Gepetto/DieBieSlaveduino/photos/stlink.jpeg

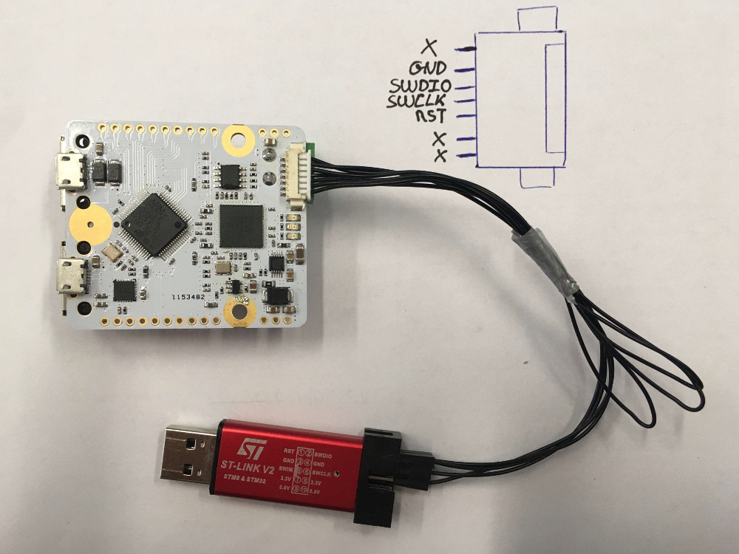
photos/stlink.jpeg
