Gepetto/DieBieSlaveduino/photos/twincat_opmode.png

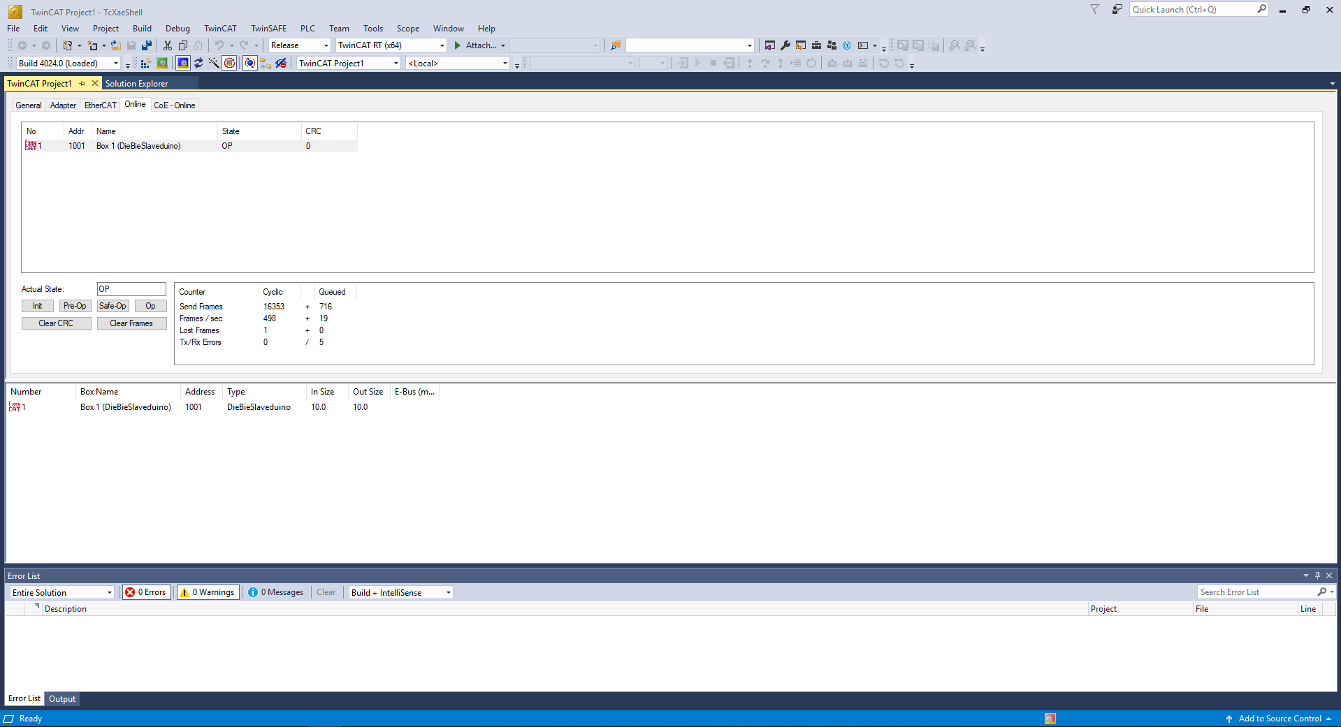
photos/twincat_opmode.png
