Gepetto/DieBieSlaveduino/hardware/BOM ethercat.ods

Sheet: ethercat
Designator | MPN origine | Quantity x1 | Quantity x5 | Quantity x4 | MPN remplacement farnell | ref Farnell | Référence Digi-Key | statut
C1, C4, C7, C8, C67, C71, C89 | C0805C104K5RACTU | 7 | 35 | 28 | C0805X104K5RACTU | 1414041 | x
C2, C3 | 12065D475KAT2A | 2 | 10 | 8 | C1206C475K5PACTU | 1572637 | x
C5, C6, C68, C69 | GRM21BR71C475KA73L | 4 | 20 | 16 | GCM21BR71C475KA73L | 2611880 | x
C12, C20, C25, C44, C46 | GRM155R71H223KA12D | 5 | 25 | 20 | GCM155R71H223KA55D | 2688473 | x
C13 | GRM155R60J225ME15D | 1 | 5 | 4 | GRM155R60J225ME15D | 2362088 | x
C14, C17, C19, C36, C40, C41 | GRM155R71E104KE14D | 6 | 30 | 24 | MC0402B104K250CT | 2320759 | x
C15, C16, C18, C72, C75 | GRM188R61C225KE15D | 5 | 25 | 20 | CC0603KRX5R7BB225 | 1458897 | x
C21, C22, C23, C24, C47, C48, C49, C50 | GRM1555C1H150JA01D | 8 | 40 | 32 | GRM0335C1H150JA01D | 2494203 | x
C26, C27, C31, C32, C33, C34, C35, C42, C43, C45, C51, C52, C53, C54, C56, C57, C58, C61, C62, C63, C64, C65, C66, C70 | GRM155R71C104KA88D | 24 | 120 | 96 | CC0402KRX7R7BB104 | 9402047 | x
C28 | 04026D105KAT2A | 1 | 5 | 4 | 04026D105KAT2A | 1327658 | x
C29 | GRM1555C1H221JA01D | 1 | 5 | 4 | CC0402JRNPO9BN221 | 3019240 | x
C37 | GRM155R71E153KA61D | 1 | 5 | 4 | x | x | 490-3251-1-ND
C38, C39, C59, C60 | GRM1555C1H180JA01D | 4 | 20 | 16 | x | x | 490-5858-1-ND
C73, C74 | GRM188R60J106ME47D | 2 | 10 | 8 | CC0603MRX5R5BB106 | 1458902 | x
C134, C143 | GRM21BR70J106KE76L | 2 | 10 | 8 | CGA4J1X7R0J106K125AC | 2210949 | x
D1, D2, D6, D9, D10, D11 | KP-2012SGC | 6 | 30 | 24 | KP-2012SGC | 1318243 | x
D3, D5 | STTH4R02U | 2 | 10 | 8 | STTH4R02U | 1295277 | x
D4, D7, D8 | PMEG3050EP | 3 | 15 | 12 | PMEG3050EP | 1829197 | x
IC | STM32F303RET6 | 1 | 5 | 4 | x | x | 497-15163-ND
IC1 | LAN9252/ML | 1 | 5 | 4 | LAN9252/ML | 2920821 | x
IC5 | CP2104-F03-GM | 1 | 5 | 4 | CP2104-F03-GM | 2930580 | x
IC8 | M24C16-WMN6P | 1 | 5 | 4 | x | x | 497-17785-1-ND
J1, J4 | 74980111211 | 2 | 10 | 8 | 74980111211 | 2407403 | x
J2 | 691313510002 | 1 | 5 | 4 | 691313510002 | 1641993 | x
J3 | 53261-0771 | 1 | 5 | 4 | 53261-0771 | 1125361 | x
J7, J8 | USB3075-30-A | 2 | 10 | 8 | USB3075-30-A | 2443115 | x
J11 | EVQPLMA15 | 1 | 5 | 4 | EVQPLMA15 | 2079484 | x
L1 | 744052100 | 1 | 5 | 4 | 744052100 | 1635854 | x
L2, L3, L4, L5, L6 | BLM18PG330SN1D | 5 | 25 | 20 | BLM18PG330SN1D | 1515742 | x
L8 | SRN2512-2R2M | 1 | 5 | 4 | SRN2512-2R2M | 2428203 | x
R1, R2, R3, R4, R13, R14, R15, R16 | CRCW040249R9FKED | 8 | 40 | 32 | MCMR04X49R9FTL | 2073090 | x
R5, R12, R24, R25, R26, R27, R28, R51, R63, R66 | CRCW04024K75FKED | 10 | 50 | 40 | CRCW04024K75FKED | 1469713 | x
R6, R7, R18, R30, R31, R32, R33, R64, R107, R108 | CRG0402F470R | 10 | 50 | 40 | CRG0402F470R | 2331533 | x
R8, R17 | MCHP03W8F100JT5E | 2 | 10 | 8 | MCWF06P10R0FTL | 2694037 | x
R9, R11 | CRCW0402240RFKED | 2 | 10 | 8 | CRCW0402240RFKED | 2140710 | x
R10 | CRG0402F12K | 1 | 5 | 4 | CRG0402F12K | 2331453 | x
R19 | CRCW0402100KFKED | 1 | 5 | 4 | CRCW0402100KFKED | 1469671 | x
R20 | CRCW0603110KFKEA | 1 | 5 | 4 | CRCW0603110KFKEA | 2138501 | x
R21, R23, R54, R73 | CRCW040210K0FKED | 4 | 20 | 16 | ASC0402-10KFT10 (https://fr.farnell.com/tt-electronics-welwyn/asc0402-10kft10/res-couche-epaisse-10k-1-0-063w/dp/2078868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) | 2078868 | x
R22 | ERJL06KF50MV | 1 | 5 | 4 | x | x | P50LLCT-ND
R29 | CRCW04021K50FKED | 1 | 5 | 4 | CRCW04021K50FKED | 1653201 | x
R72 | CRCW040245K3FKED | 1 | 5 | 4 | ERJ2RKF4532X | 2302804 | x
U1 | LM25011MY/NOPB | 1 | 5 | 4 | x | x | LM25011MY/NOPBCT-ND |  | total /fornisseur HT | 239.38 | 65.07
U3 | LMR10510XMFE/NOPB | 1 | 5 | 4 | x | x | LMR10510XMFE/NOPBCT-ND
X1 | 7M-12.000MAAJ-T | 1 | 5 | 4 | x | x | 887-1121-1-ND |  | TOTAL HT pour 4 cartes | 304.45
X2 | 7M-25.000MAAJ-T | 1 | 5 | 4 | x | x | 887-1132-1-ND
TOTAL HT |  |  |  |  |  | 239.38 | 65.07
Statut commandes
Farnell | en cours au 25/06/19
Digi-Key | reçu 24/06/19

Sheet: nomenclature
Designator
C1, C4, C7, C8, C67, C71, C89
C2, C3
C5, C6, C68, C69
C12, C20, C25, C44, C46
C13
C14, C17, C19, C36, C40, C41
C15, C16, C18, C72, C75
C21, C22, C23, C24, C47, C48, C49, C50
C26, C27, C31, C32, C33, C34, C35, C42, C43, C45, C51, C52, C53, C54, C56, C57, C58, C61, C62, C63, C64, C65, C66, C70
C28
C29
C37
C38, C39, C59, C60
C73, C74
C134, C143
D1, D2, D6, D9, D10, D11
D3, D5
D4, D7, D8
IC
IC1
IC5
IC8
J1, J4
J2
J3
J7, J8
J11
L1
L2, L3, L4, L5, L6
L8
R1, R2, R3, R4, R13, R14, R15, R16
R5, R12, R24, R25, R26, R27, R28, R51, R63, R66
R6, R7, R18, R30, R31, R32, R33, R64, R107, R108
R8, R17
R9, R11
R10
R19
R20
R21, R23, R54, R73
R22
R29
R72
U1
U3
X1
X2
TOTAL HT
Statut commandes
Farnell
Digi-Key
