Gepetto/DieBieSlaveduino/hardware/DB10012_DieBieSlave.PDF

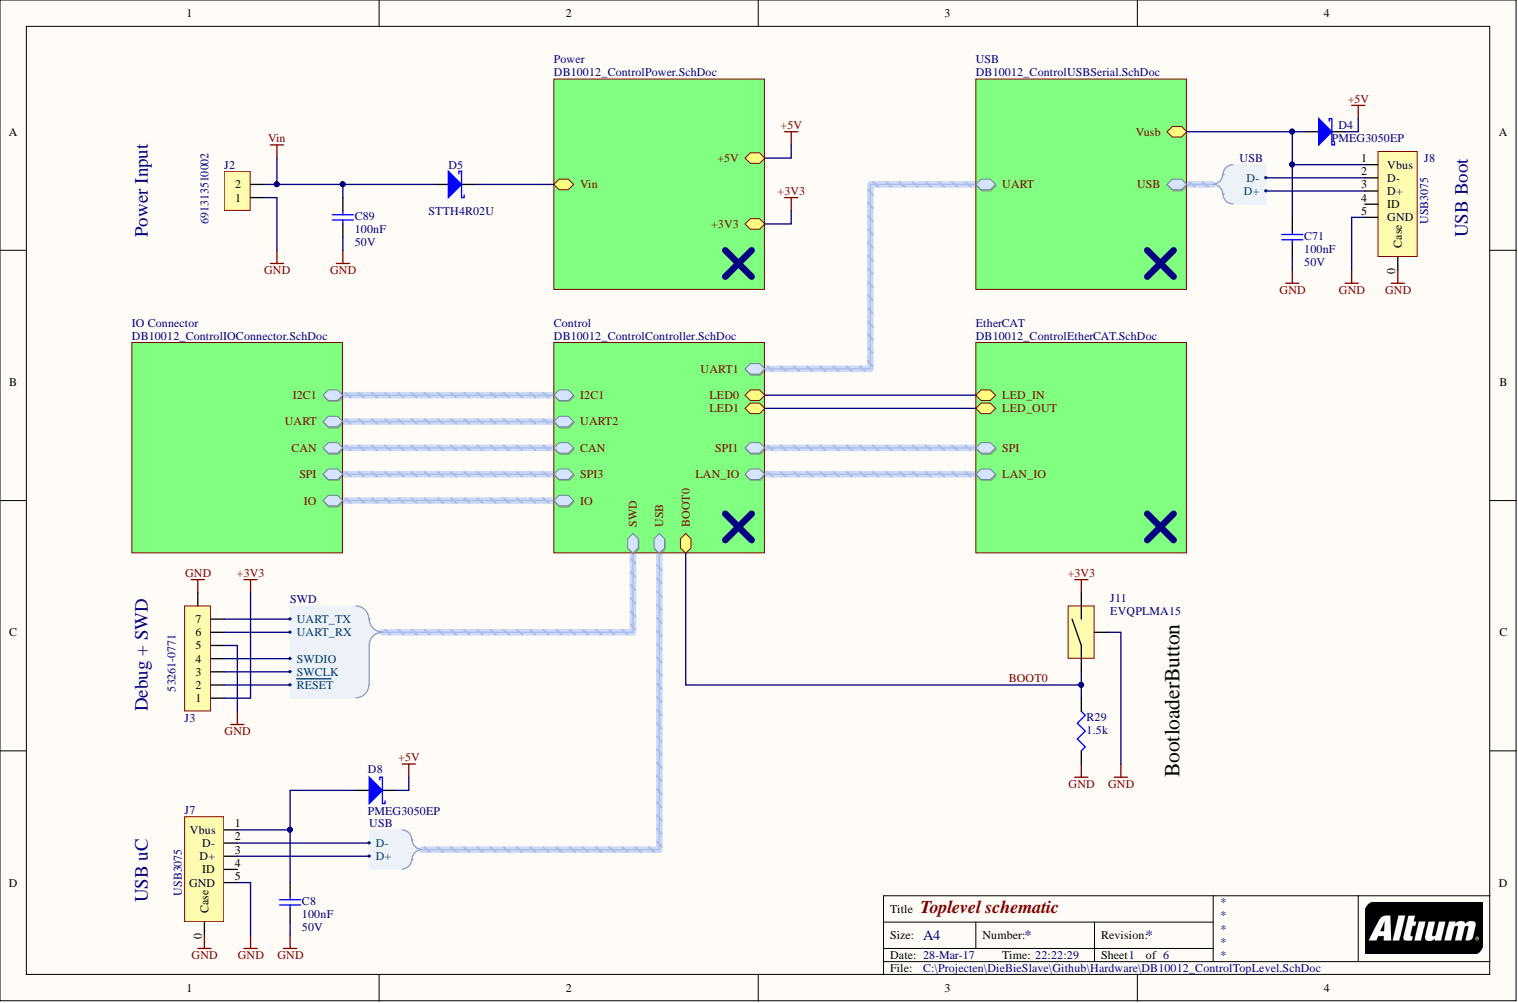
[picture p4: page 1]

Size: A | N umber: | Rev s
Date: 8-Mar-1 T ime: : | | Sheet f

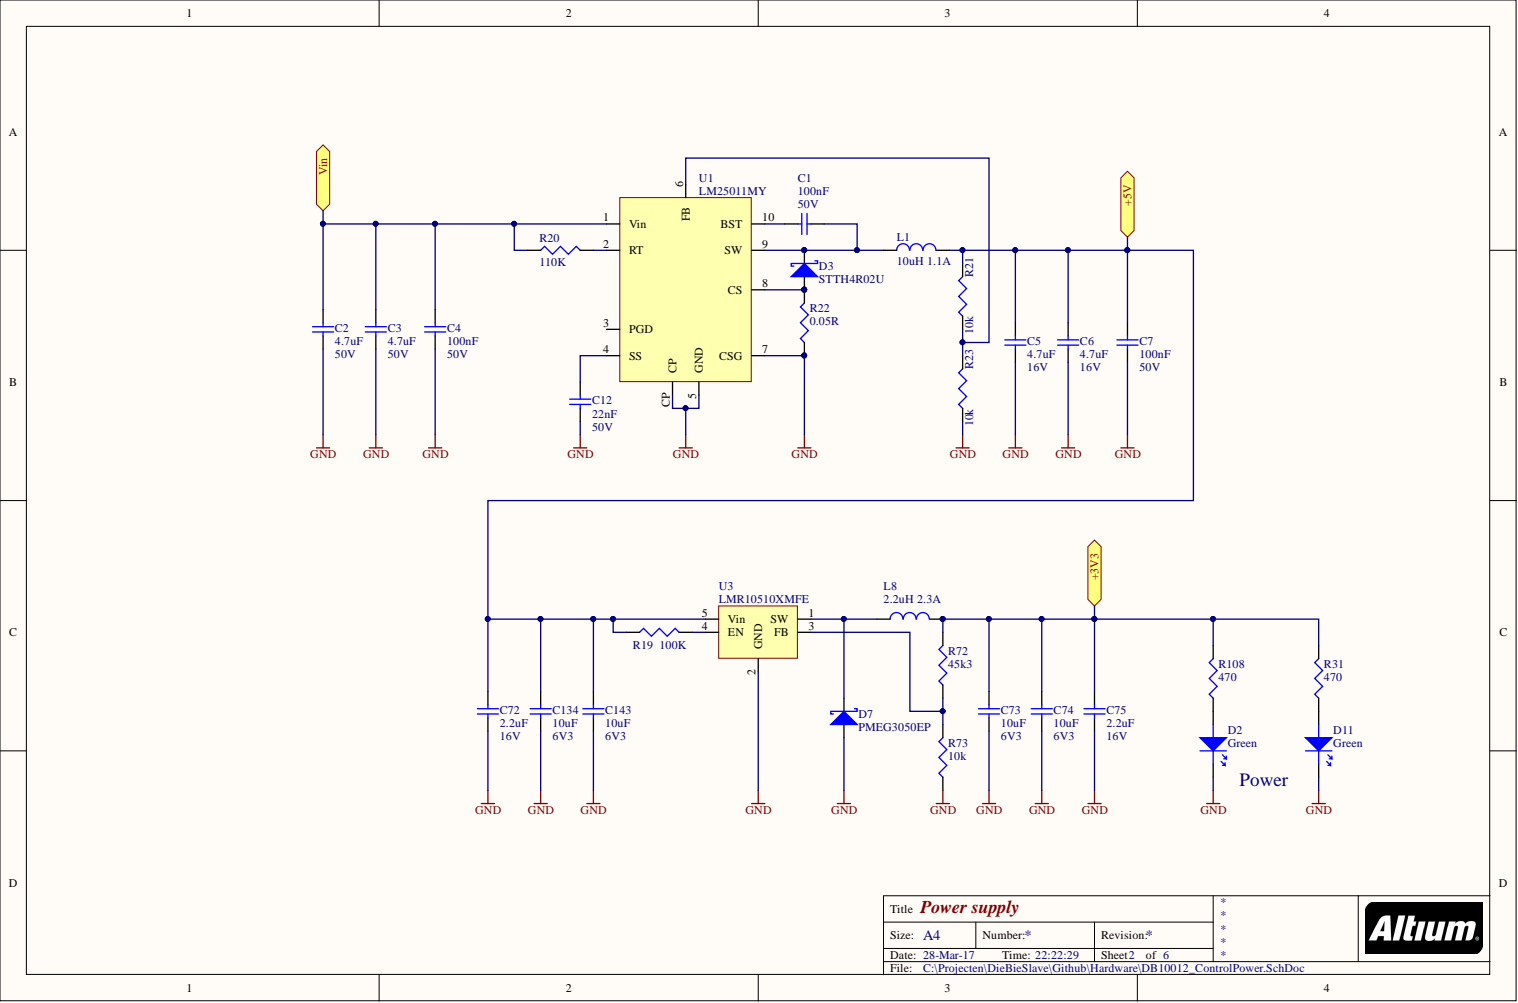
[picture p5: page 2]

Vin 1

Title Power supply | * *

Size: A4 | Number: * | Revision: *
28-Mar-17 Time: 22:22:29 | | Sheet of

C:\Projecten\DieBieSlave\Github\Hardware\DB10012_ControlPower.SchDoc

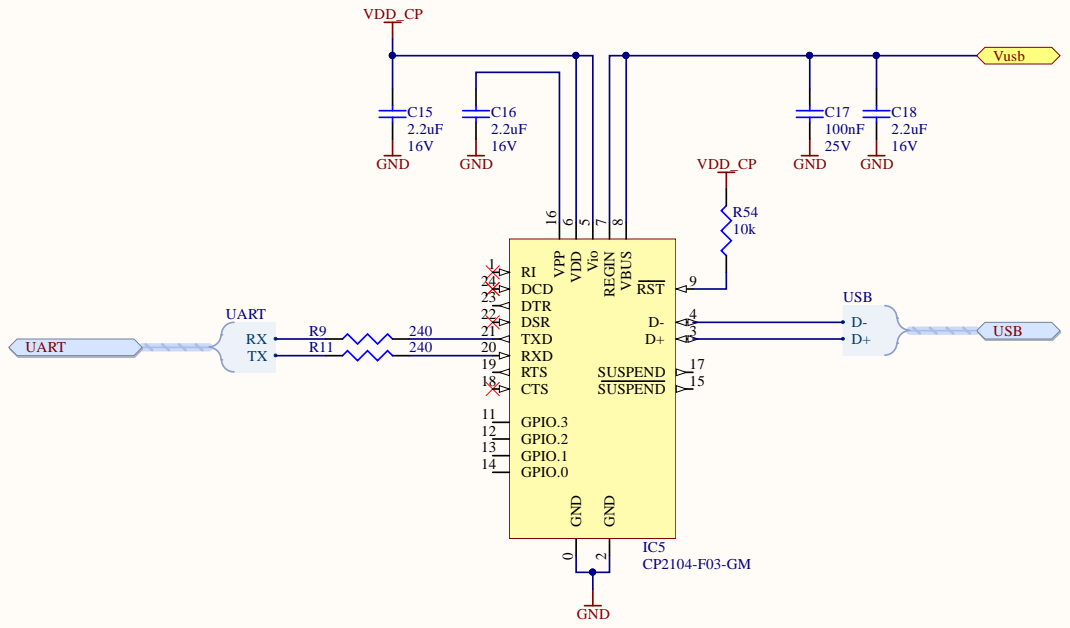
[picture p6: page 3]

C:\Projecten\DieBieSlave\Github\Hardware\DB10012_ControlUSBSerial.SchDoc

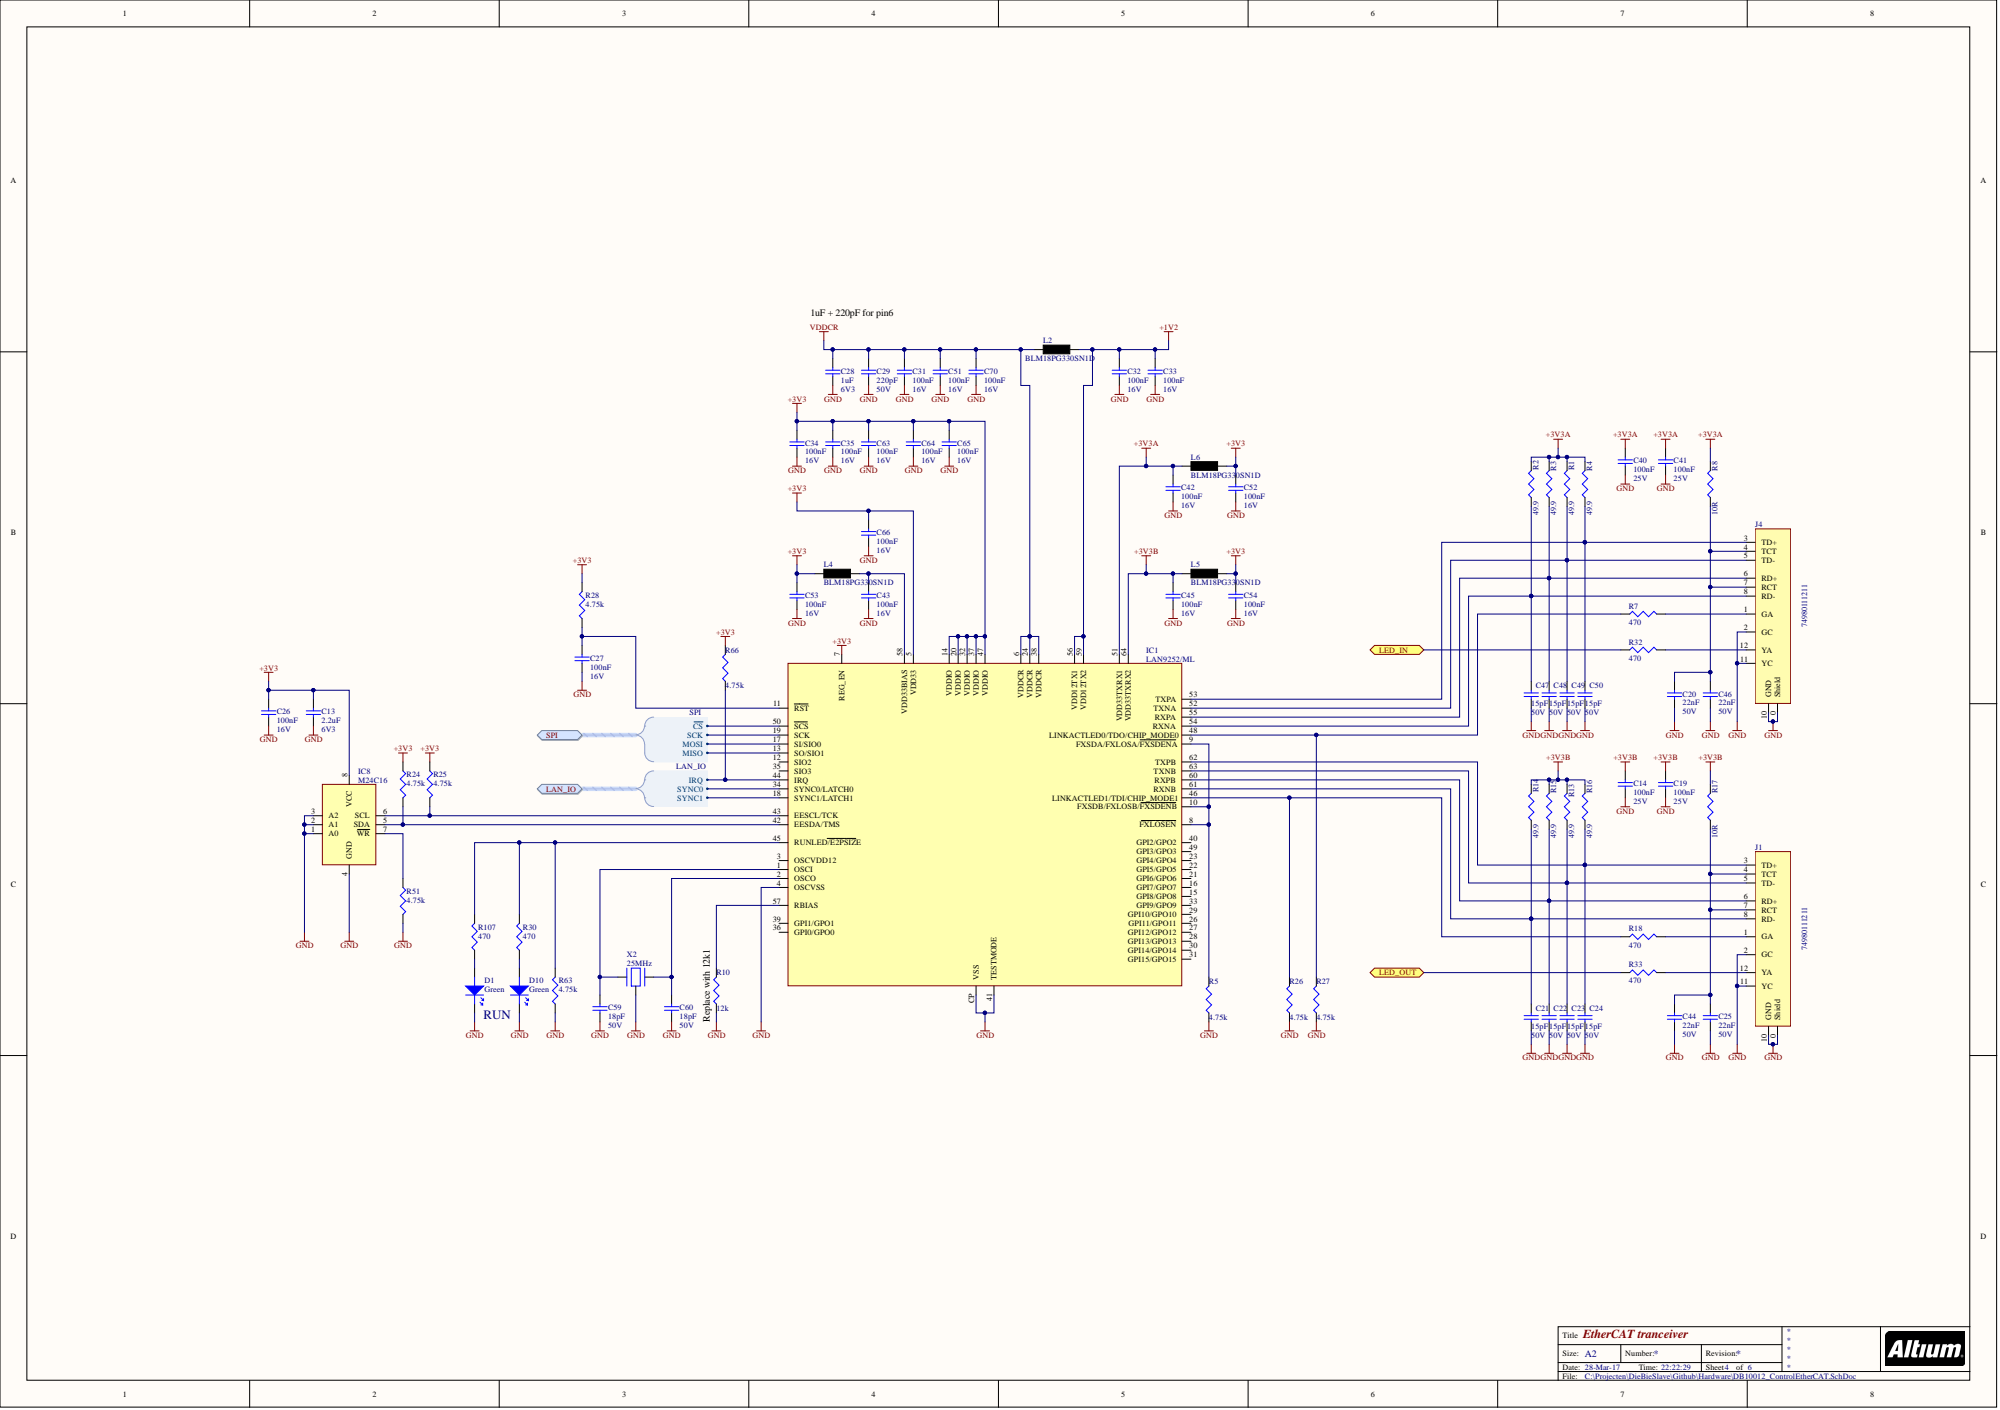
[picture p7: page 4]

6 0
6 1

4 6
1 0 | | G

2 | 5 | 4 2
1 | 7 | | 4 0 9 3 2

5 3 | | | | | 6
9 6 | | | | | 7

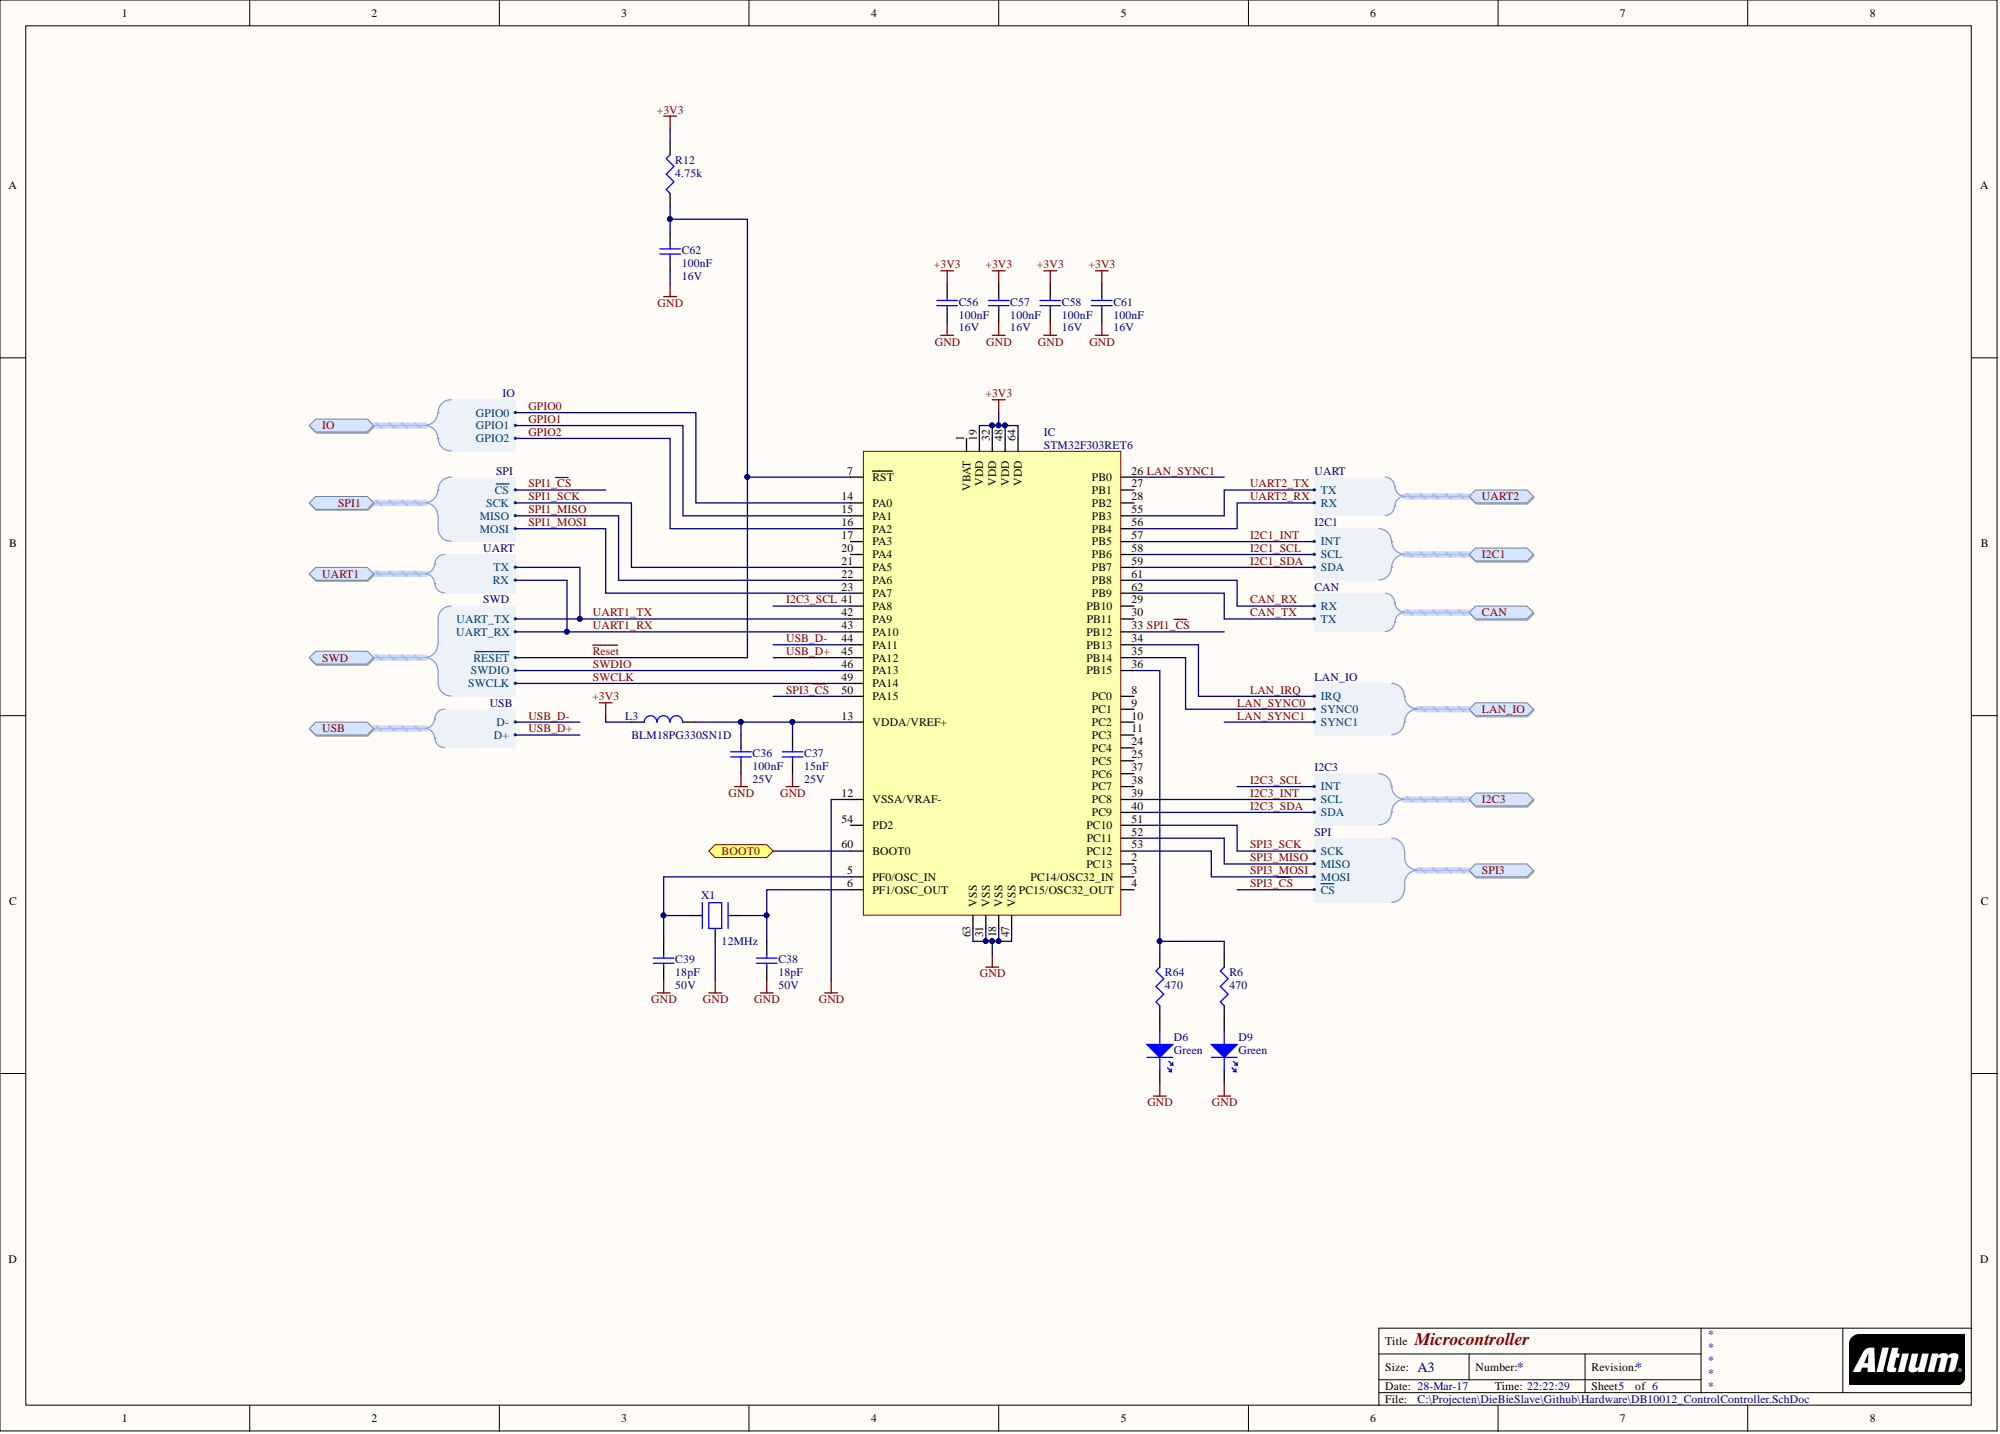
[picture p8: page 5]

GPIO 1
GPIO 2

SPI1 _CS

SPI1 _MISO | | | | 5 5
SPI1 _MOSI | | | | 5 6

2 | 3 | | 6 2

I2C3 _SCL 4 1 _ T X 4 | 1 2 | | 2 9 CA N _RX

USB_ D -4 USB_ D + 4 | | | 4 5

3 5
3 6

9 | L A N _SY NC0
1 0 1 4 5 7 8 9

5 3 | SPI3 _SCK
2 | SPI3 _MISO
3 | SPI3 _MOSI

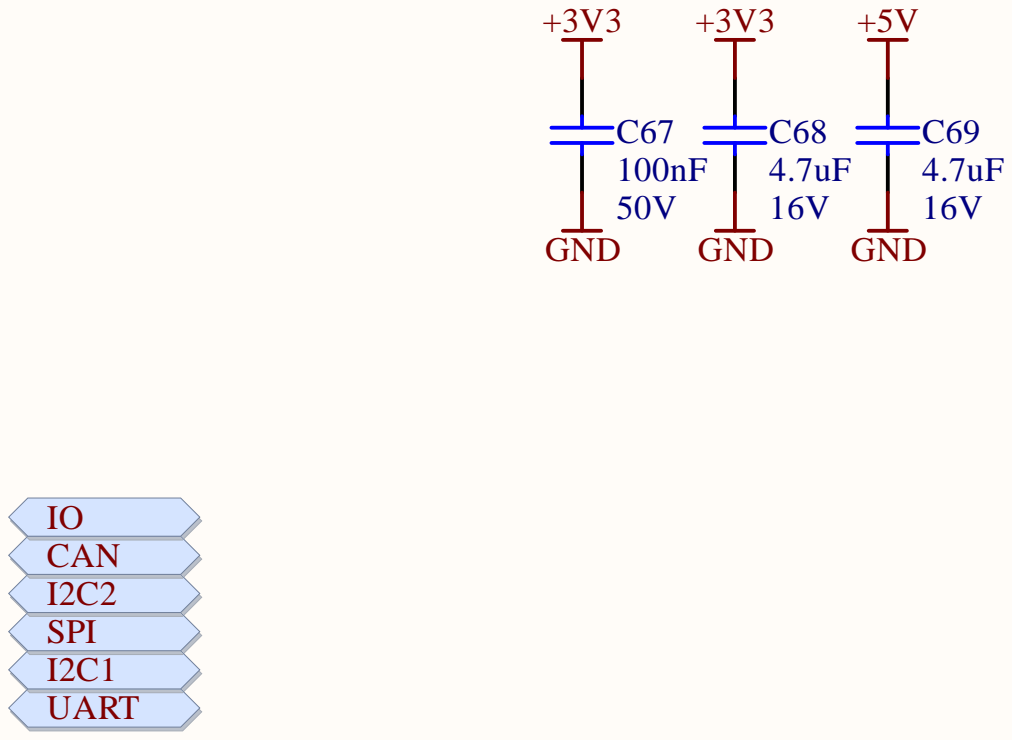
[picture p9: page 6]

C:\Projecten\DieBieSlave\Github\Hardware\DB10012_ControlIOConnector.SchDoc
