Gepetto/DieBieSlaveduino/src/DBSDuino_ds18b20/DieBieSlaveduino_float.h

#ifndef CUSTOM_PDO_NAME_H
#define CUSTOM_PDO_NAME_H

//-------------------------------------------------------------------//
//                                                                   //
//     This file has been created by the Easy Configurator tool      //
//                                                                   //
//     Easy Configurator project DieBieSlaveduino_float.prj
//                                                                   //
//-------------------------------------------------------------------//


#define CUST_BYTE_NUM_OUT	1
#define CUST_BYTE_NUM_IN	4
#define TOT_BYTE_NUM_ROUND_OUT	4
#define TOT_BYTE_NUM_ROUND_IN	4


typedef union												//---- output buffer ----
{
	uint8_t  Byte [TOT_BYTE_NUM_ROUND_OUT];
	struct
	{
		uint8_t     OutputVariable_uint8;
	}Cust;
} PROCBUFFER_OUT;


typedef union												//---- input buffer ----
{
	uint8_t  Byte [TOT_BYTE_NUM_ROUND_IN];
	struct
	{
		float       InputVariable_float;
	}Cust;
} PROCBUFFER_IN;

#endif
