Gepetto/DieBieSlaveduino/(commit log)

2019-09-24 adding hardware files
    [BOM ethercat.ods]
2019-09-25 adding examples
    [log_configuration.txt]
